alexanderbarsuk/diesel-heater/tools/background.png

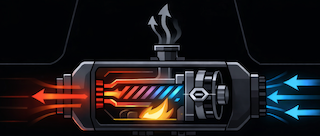
tools/background.png
