alexanderbarsuk/diesel-heater/README.md

# MegaHeater2

Мікроконтролерна система керування автономним дизельним обігрівачем.

## Апаратна платформа

| Компонент | Деталь |
|---|---|
| MCU | Arduino Mega 2560 (ATmega2560, 256 KB Flash, 8 KB RAM) |
| Дисплей | ST7789 TFT 320×240, підключення через SPI |
| Енкодер | Ротаційний енкодер з кнопкою |
| Термопари | MAX6675 × 3 (K-type, SPI) |
| Датчик впуску | DS18B20 (One-Wire) |
| Датчик середовища | AHT20 (температура + вологість, I2C) + BMP280 (тиск, I2C) |
| Датчик струму | ACS712F 20A (вимірювання струму свічки) |
| Дільник напруги | Резисторний дільник R1=30 кОм, R2=10 кОм → Vmax≈20 В |

---

## Підключення сенсорів і виходів

### SPI (SCK=52, MISO=50, MOSI=51)
| Пін CS | Сенсор |
|---|---|
| 10 | MAX6675 — камера згорання |
| 11 | MAX6675 — вихлоп |
| 12 | MAX6675 — повітря на виході (тепле) |
| 53 | ST7789 TFT — CS |
| 48 | ST7789 TFT — DC |
| 49 | ST7789 TFT — RST |

### I2C (SDA=20, SCL=21)
| Адреса | Сенсор |
|---|---|
| 0x38 | AHT20 (температура + вологість) |
| 0x76 або 0x77 | BMP280 (атмосферний тиск) |

### One-Wire
| Пін | Сенсор |
|-----|---|
| 23 | DS18B20 — повітря на вході (холодне) |

### Аналогові входи
| Пін | Призначення |
|-----|---|
| A0 | Дільник напруги живлення (≤20 В через дільник R1=30к/R2=10к) |
| A1 | ACS712F 20A — струм свічки запалювання (0A → 2.5V / ADC≈512; ~20.5 ADC/А) |

> **Важливо:** A0 при непідключеному дільнику є плаваючим входом і показує шум. Підключіть 10 кОм на GND при відсутності дільника.

### Цифрові входи
| Пін | Режим | Призначення |
|-----|---|---|
| 2 | INPUT (INT) | Енкодер CLK |
| 3 | INPUT (INT) | Енкодер DT |
| 4 | INPUT | Енкодер SW (кнопка) |
| 5 | INPUT | Кнопка перемикання екранів |
| 18 | INPUT_PULLUP (INT3) | Тахометр вентилятора (2 імп/об) |
| 19 | INPUT_PULLUP (INT2) | Тахометр насоса (1 імп/об) |
| 24 | INPUT | Аварійний контакт (HIGH = спрацювало) |
| 25 | INPUT | Датчик переливу пального (HIGH = спрацювало) |
| 26 | INPUT | Датчик мінімуму пального (HIGH = спрацювало) |
| 28 | INPUT | Кнопка режиму "Нагрів" (HIGH = натиснуто) |
| 30 | INPUT | Кнопка режиму "Вентиляція" (HIGH = натиснуто) |
| 32 | INPUT | Кнопка прокачки пального (HIGH = натиснуто) |
| 34 | INPUT | Вхід ехо-сигналу (дублюється на пін 35) |

### Цифрові виходи
| Пін | Призначення | Активний рівень |
|-----|---|---|
| 6 | ШІМ вентилятора (OC4A, Timer4) | HIGH |
| 7 | ШІМ паливного насоса (OC4B, Timer4) | HIGH |
| 8 | Паливний клапан | HIGH = відкрито |
| 9 | Свічка запалювання | HIGH = активна |
| 27 | Зарядка акумулятора | HIGH = заряджати |
| 29 | LED режиму "Нагрів" | HIGH = світить |
| 31 | LED режиму "Вентиляція" | HIGH = світить |
| 33 | Бузер | HIGH = звук |
| 35 | Вихід ехо-сигналу (дублює пін 34) | — |
| 46 | Тактовий сигнал 2 Гц (OC5A, Timer5 CTC) | меандр |

---

## Режими роботи

| Режим | Опис |
|---|---|
| **Нагрів** (MODE_HEAT) | Нормальний режим. Вентилятор + насос + свічка під час запуску |
| **Вентиляція** (MODE_VENT) | Тільки вентилятор, насос і свічка не вмикаються |

Режим обирається кнопками BTN_HEAT / BTN_VENT тільки у стані ВИМКНЕНО або ПОМИЛКА.

---

## Стани обігрівача

```
                          [ignitionTime вичерпано, 1-ша спроба]
                        ┌─────────────────────────────────────┐
                        │                                     ▼
ВИМКНЕНО ─[Toggle]─► ЗАПУСК                             ПЕРЕЗАПУСК
                        │                                     │
               [вихлоп ≥ startFireTemp]            [вихлоп ≥ startFireTemp]
                        │                                     │
                        └──────────► НОРМАЛЬНА РОБОТА ◄───────┘
                                           │   │
                                    [Toggle]   [вихлоп < startFireTemp]
                                           │               │
                                           ▼               ▼
              FAULT ◄─[ignitionTime]─ ОХОЛОДЖЕННЯ ◄── ПЕРЕЗАПУСК (одна спроба)
                                           │
                                  [камера ≤ coolStopTemp]
                                           │
                                           ▼
                                    ВИМКНЕНО / ПОМИЛКА
```

| Стан | Клапан | Свічка | Вентилятор | Насос |
|---|---|---|---|---|
| ВИМКНЕНО | — | — | — | — |
| ЗАПУСК | Відкрито | Увімкнена (до ignitionTime) | startFanRpm | startPumpRpm (після затримки) |
| ПЕРЕЗАПУСК | Відкрито | Увімкнена (до ignitionTime) | startFanRpm | startPumpRpm (після затримки) |
| НОРМАЛЬНА РОБОТА | Відкрито | — | POWER_TABLE[power] | POWER_TABLE[power] |
| ОХОЛОДЖЕННЯ | — | — | coolFanRpm | — |
| ПОМИЛКА | — | — | — | — |
| ПРОКАЧКА | Відкрито | — | — | MAX (255) |

---

## Алгоритм запуску

1. Натиснута кнопка Toggle → стан переходить у **ЗАПУСК**
2. Вмикається паливний клапан
3. Вентилятор виходить на `startFanRpm` через ПІД-регулятор
4. Свічка запалювання вмикається
5. Якщо задана `Затримка насоса` > 0 — насос стоїть задану кількість секунд
6. Після затримки насос виходить на `startPumpRpm` через ПІД
7. Через 1000 мс після ввімкнення свічки — перевірка струму ACS712:
   - Якщо струм < `Мін.струм свічки` і налаштування ≠ 0 → **FAULT_IGNITION_OPEN**
8. Якщо температура вихлопу досягає `startFireTemp` → стан **НОРМАЛЬНА РОБОТА**, свічка вимикається
9. Якщо час `ignitionTime` вичерпано і займання не відбулося:
   - Перша спроба → **ПЕРЕЗАПУСК** (повторює кроки 3–8)
   - Друга спроба не вдалася → **FAULT_NO_IGNITION** → **ОХОЛОДЖЕННЯ**

## Відновлення після перебою живлення

При увімкненні контролера виконується перевірка температури камери згорання:
- Якщо `tempChamber > coolStopTemp` → контролер одразу переходить у стан **ОХОЛОДЖЕННЯ**
- Вентилятор виходить на `coolFanRpm` і охолоджує камеру до досягнення порогу
- Після охолодження — стан **ВИМКНЕНО** (без аварії)

Це захищає від ситуацій, коли живлення зникло під час роботи обігрівача.

## Алгоритм зупинки

1. Натиснута кнопка Toggle (або спрацювала аварія) → стан **ОХОЛОДЖЕННЯ**
2. Паливний клапан і свічка вимикаються, насос зупиняється
3. Вентилятор виходить на `coolFanRpm` через ПІД
4. Коли температура камери ≤ `coolStopTemp` → стан **ВИМКНЕНО** (або **ПОМИЛКА** якщо причина аварія)

## Алгоритм прокачки

- Режим **Утримання**: насос на MAX при натиснутій кнопці PRIMING, зупиняється при відпусканні
- Режим **Таймер**: насос на MAX протягом заданого часу після натискання кнопки
- Доступна тільки у стані ВИМКНЕНО або ПОМИЛКА
- Паливний клапан відкривається під час прокачки

## ПІД-регулятори

Velocity-form PI (оновлення раз на 1 секунду):

```
Δu = Kp*(e - e_prev) + Ki*e
u[k] = clamp(u[k-1] + Δu, 0, 255)
```

| Параметр | За замовч. | Одиниці |
|---|---|---|
| Вентилятор Kp | 0.040 | ШІМ/RPM |
| Вентилятор Ki | 0.008 | ШІМ/RPM |
| Насос Kp | 0.400 | ШІМ/RPM |
| Насос Ki | 0.080 | ШІМ/RPM |

## Таблиця потужності (10 ступенів)

| Ступінь | Вентилятор (об/хв) | Насос (об/хв) |
|---|---|---|
| 1 | 1200 | 60 |
| 2 | 1550 | 78 |
| 3 | 1950 | 102 |
| 4 | 2350 | 132 |
| 5 | 2750 | 168 |
| 6 | 3150 | 210 |
| 7 | 3550 | 258 |
| 8 | 3950 | 312 |
| 9 | 4350 | 372 |
| 10 | 4800 | 420 |

## Зарядка акумулятора

Якщо напруга живлення нижче порогу `Поріг зарядки` — вихід CHARGER_PIN переходить у HIGH (ввімкнення зовнішнього зарядника). Перевіряється кожну секунду.

## Таймер автовимкнення

При ввімкненому таймері обігрівач автоматично зупиняється після заданого часу роботи. Налаштовується через меню (увімкнення + тривалість).

---

## Перелік помилок

| Код | Короткий код | Назва | Умова спрацювання |
|-----|---|---|---|
| 1 | Е:КАМ | ПЕРЕГРІВ КАМЕРИ | tempChamber > maxChamber (за замовч. 310°C) |
| 2 | Е:ВИХ | ПЕРЕГРІВ ВИХЛОПУ | tempExhaust > maxExhaust (за замовч. 380°C) |
| 3 | Е:ЗАП | НЕ ЗАПАЛЮЄТЬСЯ | Вихлоп не досяг startFireTemp за обидві спроби ignitionTime |
| 4 | Е:СКМ | ДАТЧИК КАМЕРИ | MAX6675 повертає NAN (термопара відключена) |
| 5 | Е:СВХ | ДАТЧИК ВИХЛОПУ | MAX6675 повертає NAN (термопара відключена) |
| 6 | Е:НАП | НИЗЬКА НАПРУГА | voltage < voltageMin (за замовч. 8.0 В) |
| 7 | Е:ВАП | ВИСОКА НАПРУГА | voltage > voltageMax (за замовч. 30.0 В) |
| 8 | Е:КОН | АВАРІЙНИЙ КОНТАКТ | SENSOR_EMERGENCY_PIN = HIGH |
| 9 | Е:ПЕР | ПЕРЕЛИВ ПАЛЬНОГО | SENSOR_FUEL_OVERFLOW_PIN = HIGH |
| 10 | Е:БАК | МІНІМУМ ПАЛЬНОГО | SENSOR_FUEL_MIN_PIN = HIGH |
| 11 | Е:ВПС | ПЕРЕГРІВ ВПУСКУ | tempAirIn > maxAirIn (за замовч. 20°C) |
| 12 | Е:СВЧ | ОБРИВ СВІЧКИ | Струм свічки < Мін.струм через 1 с після ввімкнення (якщо налаштування ≠ 0) |

**Поведінка при аварії:**
- Під час активної роботи → стан **ОХОЛОДЖЕННЯ** (вентилятор продовжує працювати до coolStopTemp)
- Після охолодження → стан **ПОМИЛКА**
- З ВИМКНЕНО або ЗУПИНКИ → одразу **ПОМИЛКА**

Журнал помилок зберігається в EEPROM (кільцевий буфер, до 100 записів). Переглядається на екрані аварій.

---

## Налаштування

Доступні через екран налаштувань (поворот енкодера = навігація, натискання = редагування/підтвердження).

### Головне меню

| Параметр | Тип | Діапазон | За замовч. | Опис |
|---|-----|---|---|---|
| Таймер | Checkbox | Викл/Вкл | Викл | Увімкнення таймера автовимкнення |
| Час таймера | Час | 0–23:59:59 | 0:30:00 | Тривалість роботи за таймером |
| Режим прокачки | Вибір | Утримання / Таймер | Утримання | Режим кнопки прокачки |
| Час прокачки | Час | 0–23:59:59 | 0:00:10 | Тривалість прокачки в режимі Таймер |
| Напруга живлення | Діапазон | 3–30 В | 10–25 В | Допустимий діапазон напруги |
| Поріг зарядки | Слайдер | 9–14 В | 11 В | Нижче — вмикається зарядник |

### Підменю "Запуск"

| Параметр | Тип | Діапазон | За замовч. | Опис |
|---|-----|---|---|---|
| Час роботи свічки | Час | 0–23:59:59 | 0:01:00 | Максимальний час роботи свічки за одну спробу |
| Оберти вентилятора | Слайдер | 500–3000 RPM | 1200 RPM | Оберти вентилятора під час запуску |
| Оберти насоса | Слайдер | 30–500 RPM | 60 RPM | Оберти насоса під час запуску |
| Температура займання | Слайдер | 100–500°C | 300°C | Температура вихлопу, що підтверджує займання |
| Затримка насоса | Слайдер | 0–120 с | 0 с | Час після старту, протягом якого насос не вмикається |

### Підменю "Зупинка"

| Параметр | Тип | Діапазон | За замовч. | Опис |
|---|-----|---|---|---|
| Оберти вентилятора | Слайдер | 500–3000 RPM | 1500 RPM | Оберти вентилятора під час охолодження |
| Цільова температура | Слайдер | 30–150°C | 80°C | Температура камери для завершення охолодження |

### Підменю "Аварії"

| Параметр | Тип | Діапазон | За замовч. | Опис |
|---|-----|---|---|---|
| Макс темп впуску | Слайдер | 5–30°C | 20°C | Максимально допустима температура холодного повітря на вході |
| Перегрів корпусу | Слайдер | 300–500°C | 310°C | Поріг аварії камери згорання |
| Перегрів вихлопу | Слайдер | 300–600°C | 380°C | Поріг аварії вихлопної труби |
| Мін.струм свічки | Слайдер | 0–20 А | 2 А | Мінімальний струм для підтвердження роботи свічки (0 = перевірку вимкнено) |
| Час бузера | Слайдер | 0–30 с | 3 с | Тривалість звукового сигналу при аварії (0 = вимкнено) |

### Підменю "ПІД регулятор"

| Параметр | Тип | Діапазон | За замовч. | Опис |
|---|-----|---|---|---|
| Вентилятор Kp | Слайдер | 0–0.999 | 0.040 | Пропорційний коефіцієнт вентилятора |
| Вентилятор Ki | Слайдер | 0–0.999 | 0.008 | Інтегральний коефіцієнт вентилятора |
| Насос Kp | Слайдер | 0–0.999 | 0.400 | Пропорційний коефіцієнт насоса |
| Насос Ki | Слайдер | 0–0.999 | 0.080 | Інтегральний коефіцієнт насоса |

### Підменю "Потужність"

10 ступенів (1–10). Кожен задає цільові оберти насоса та вентилятора у вигляді діапазону (lo=насос, hi=вентилятор, 0–5000 RPM).

---

## EEPROM

| Адреса | Розмір | Призначення |
|---|---|---|
| 6 | 4 B | Час прокачки (секунди) |
| 14 | 4 B | Час прокачки (TIME) |
| 18 | 4 B | Час роботи свічки (TIME) |
| 24 | 2 B | Поріг зарядки |
| 26 | 2 B | Режим прокачки |
| 28 | 2 B | Оберти вентилятора запуску |
| 32 | 2 B | Макс темп впуску |
| 34 | 2 B | Перегрів корпусу |
| 36 | 2 B | Перегрів вихлопу |
| 38–44 | 2 B × 4 | ПІД коефіцієнти (×1000) |
| 46–85 | 4 B × 10 | Таблиця потужності (10 ступенів) |
| 86 | 2 B | Оберти насоса запуску |
| 88 | 2 B | Температура займання |
| 90 | 2 B | Оберти вентилятора охолодження |
| 92 | 2 B | Температура зупинки охолодження |
| 94 | 2 B | Таймер увімкнений |
| 96 | 4 B | Тривалість таймера (секунди) |
| 100 | 1 B | Magic byte налаштувань (0xB0) |
| 102 | 2 B | Затримка насоса при запуску |
| 104 | 2 B | Мінімальний струм свічки |
| 106 | 2 B | Час бузера при аварії |
| 200–399 | 200 B | Журнал аварій (кільцевий буфер 100 × 2 байти: code + arg) |
| 400 | 1 B | Кількість записів журналу |
| 401 | 1 B | Head (індекс найстарішого запису) |
| 402 | 1 B | Seed magic журналу (0xB2) |

При невідповідності magic byte (адреса 100) усі налаштування скидаються до значень за замовчуванням і записуються в EEPROM.

---

## Збірка та прошивка

```bash
# Компіляція
arduino-cli compile --fqbn arduino:avr:mega:cpu=atmega2560 .

# Прошивка
arduino-cli upload -p /dev/cu.usbserial-110 --fqbn arduino:avr:mega:cpu=atmega2560 .
```

Поточний розмір: ~163 KB Flash (64%), ~4.7 KB RAM (57%).
