alexanderbarsuk/diesel-heater/screen_settings.cpp

#include "screen_settings.h"
#include "uaprint.h"
#include "encoder.h"
#include "config.h"
#include "heater.h"
#include "timer.h"
#include <EEPROM.h>

// ─── Типи елементів меню ─────────────────────────────────────────────────────
enum MenuItemType : uint8_t {
  ITEM_SLIDER,    // int16_t в [minVal..maxVal], відображається з одиницями
  ITEM_CHECKBOX,  // int16_t 0/1 → "ВИКЛ"/"ВКЛ"
  ITEM_TIME,      // uint32_t секунди (0..86399), 3 поля редагування: Г/Х/С
  ITEM_RANGE,     // два int16_t packed lo|hi<<16, обидва в [minVal..maxVal], lo≤hi
  ITEM_SELECT,    // int16_t індекс 0..maxVal в масиві data[]
  ITEM_SUBMENU,   // перехід у підменю; data → SubMenuDef; valIdx=NO_VAL
  ITEM_BACK,      // повернення до батьківського меню; valIdx=NO_VAL
};

#define NO_VAL 0xFF  // valIdx для ITEM_SUBMENU та ITEM_BACK

// ─── Структура підменю ───────────────────────────────────────────────────────
struct MenuItem;  // forward declaration

struct SubMenuDef {
  const char*     title;   // заголовок підменю (UTF-8, до 12 символів)
  const MenuItem* items;   // масив елементів
  uint8_t         count;   // кількість елементів
};

// ─── Структура елемента меню ─────────────────────────────────────────────────
struct MenuItem {
  const char*   label;      // UTF-8, рівно 10 видимих символів
  MenuItemType  type;
  uint8_t       valIdx;     // індекс у values[]; NO_VAL для SUBMENU/BACK
  uint8_t       eepromAddr; // EEPROM-адреса (2B для SLIDER/CHECKBOX/SELECT, 4B для TIME/RANGE)
  int16_t       minVal;     // SLIDER/RANGE: нижня межа; SELECT: 0; SUBMENU/BACK: 0
  int16_t       maxVal;     // SLIDER/RANGE: верхня межа; SELECT: кількість опцій-1
  int32_t       defaultVal; // значення за замовчуванням
  const char*   units;      // UTF-8 рядок одиниць або NULL
  const void*   data;       // SELECT: const char**; SUBMENU: const SubMenuDef*; інакше NULL
};

// ─── Рядки одиниць ───────────────────────────────────────────────────────────
static const char UNITS_C[]   = "\xC2\xB0""C";              // °C  (2 CP)
static const char UNITS_PCT[] = "%";
static const char UNITS_HPA[] = "\xD0\xB3\xD0\x9F\xD0\xB0"; // гПа (3 CP)
static const char UNITS_V[]   = "В";
static const char UNITS_RPM[] = "RPM";
static const char UNITS_S[]   = "с";
static const char UNITS_A[]   = "А";

// ─── Опції для ITEM_SELECT ───────────────────────────────────────────────────
static const char* modeOpts[]        = { "Авто ", "Нагрів", "Вентиляція" };
static const char* primingModeOpts[] = { "Утримання", "Таймер" };

// ─── Підменю "ПОТУЖНІСТЬ" (таблиця 10 ступенів) ──────────────────────────────
// lo = pumpRpm (оберти насоса), hi = fanRpm (оберти вент.) — lo≤hi завжди ✓
// valIdx 20..29  EEPROM addr 46..85  (4B кожен = ITEM_RANGE: lo(2B)+hi(2B))
#define MK_STEP(pump, fan) \
  (int32_t)((uint16_t)(pump) | ((uint32_t)(uint16_t)(fan) << 16))
static const MenuItem powerItems[] = {
  // label           type        valIdx  addr   min   max   default              units    data
  { "< Назад   ", ITEM_BACK,    NO_VAL,  0,      0,    0,   0,                  nullptr, nullptr },
  { "Ступінь 1 ", ITEM_RANGE,   20,     46,      0, 5000,   MK_STEP( 60, 1200), nullptr, nullptr },
  { "Ступінь 2 ", ITEM_RANGE,   21,     50,      0, 5000,   MK_STEP( 78, 1550), nullptr, nullptr },
  { "Ступінь 3 ", ITEM_RANGE,   22,     54,      0, 5000,   MK_STEP(102, 1950), nullptr, nullptr },
  { "Ступінь 4 ", ITEM_RANGE,   23,     58,      0, 5000,   MK_STEP(132, 2350), nullptr, nullptr },
  { "Ступінь 5 ", ITEM_RANGE,   24,     62,      0, 5000,   MK_STEP(168, 2750), nullptr, nullptr },
  { "Ступінь 6 ", ITEM_RANGE,   25,     66,      0, 5000,   MK_STEP(210, 3150), nullptr, nullptr },
  { "Ступінь 7 ", ITEM_RANGE,   26,     70,      0, 5000,   MK_STEP(258, 3550), nullptr, nullptr },
  { "Ступінь 8 ", ITEM_RANGE,   27,     74,      0, 5000,   MK_STEP(312, 3950), nullptr, nullptr },
  { "Ступінь 9 ", ITEM_RANGE,   28,     78,      0, 5000,   MK_STEP(372, 4350), nullptr, nullptr },
  { "Ступінь 10", ITEM_RANGE,   29,     82,      0, 5000,   MK_STEP(420, 4800), nullptr, nullptr },
};
static const SubMenuDef corrSubDef = { "ПОТУЖНІСТЬ", powerItems, 11 };

// ─── Підменю "АВАРІЇ" ────────────────────────────────────────────────────────
// Temp thresholds: valIdx 13..15, addr 32..36 (2B кожен)
// Ignition current: valIdx 40, addr 104 (2B)
// Buzzer duration: valIdx 41, addr 106 (2B)
static const MenuItem dangerItems[] = {
  // label                       type        valIdx  addr  min   max  default  units    data
  { "< Назад   ",             ITEM_BACK,    NO_VAL,   0,    0,    0,   0,      nullptr, nullptr },
  { "Макс темп впуску",       ITEM_SLIDER,  13,      32,    5,   30,  20,      UNITS_C, nullptr },
  { "Перегрів корпусу",       ITEM_SLIDER,  14,      34,  300,  500, 310,      UNITS_C, nullptr },
  { "Перегрів вихлопу",       ITEM_SLIDER,  15,      36,  300,  600, 380,      UNITS_C, nullptr },
  { "Мін.струм свічки",       ITEM_SLIDER,  40,     104,    0,   20,   2,      UNITS_A, nullptr },
  { "Час бузера  ",           ITEM_SLIDER,  41,     106,    0,   30,   3,      UNITS_S, nullptr },
};
static const SubMenuDef dangerSubDef = { "АВАРІЇ", dangerItems, 6 };

// ─── Підменю "ЗАПУСК" ────────────────────────────────────────────────────────
// valIdx 32..34, 39  EEPROM addr 28, 86, 88, 102  (2B кожен)
static const MenuItem startItems[] = {
  // label                      type        valIdx  addr   min   max   default  units    data
  { "< Назад   ",             ITEM_BACK,    NO_VAL,   0,     0,    0,    0,      nullptr,   nullptr },
  { "Час роботи свічки",      ITEM_TIME,     7,      18,     0,    0,   60,      nullptr,   nullptr },
  { "Оберти вентилятора",     ITEM_SLIDER,  32,      28,   500, 3000, 1200,      UNITS_RPM, nullptr },
  { "Оберти насоса",          ITEM_SLIDER,  33,      86,    30,  500,   60,      UNITS_RPM, nullptr },
  { "Температура займання",   ITEM_SLIDER,  34,      88,   100,  500,  300,      UNITS_C,   nullptr },
  { "Затримка насоса",        ITEM_SLIDER,  39,     102,     0,  120,    0,      UNITS_S,   nullptr },
};
static const SubMenuDef startSubDef = { "ЗАПУСК", startItems, 6 };

// ─── Підменю "ЗУПИНКА" ───────────────────────────────────────────────────────
// valIdx 35..36  EEPROM addr 90, 92  (2B кожен)
static const MenuItem stopItems[] = {
  // label                    type        valIdx  addr   min   max   default  units    data
  { "< Назад   ",           ITEM_BACK,    NO_VAL,   0,     0,    0,    0,      nullptr, nullptr },
  { "Оберти вентилятора",   ITEM_SLIDER,  35,      90,   500, 3000, 1500,      UNITS_RPM, nullptr },
  { "Цільова температура",  ITEM_SLIDER,  36,      92,    30,  150,   80,      UNITS_C, nullptr },
};
static const SubMenuDef stopSubDef = { "ЗУПИНКА", stopItems, 3 };

// ─── Підменю "ПІД" ───────────────────────────────────────────────────────────
// valIdx 16..19  EEPROM addr 38..44  (2B кожен)
// Значення зберігаються як ×1000 цілі: 40 = Kp 0.040 [ШІМ/RPM]
static const MenuItem pidItems[] = {
  // label              type        valIdx  addr  min   max  default  units     data
  { "< Назад   ",     ITEM_BACK,    NO_VAL,   0,    0,    0,    0,    nullptr,  nullptr },
  { "Вентилятор Kp",  ITEM_SLIDER,  16,      38,    0,  999,   40,    nullptr,  nullptr },
  { "Вентилятор Ki",  ITEM_SLIDER,  17,      40,    0,  999,    8,    nullptr,  nullptr },
  { "Насос Kp",       ITEM_SLIDER,  18,      42,    0,  999,  400,    nullptr,  nullptr },
  { "Насос Ki",       ITEM_SLIDER,  19,      44,    0,  999,   80,    nullptr,  nullptr },
};
static const SubMenuDef pidSubDef = { "ПІД", pidItems, 5 };

// ─── Головне меню ────────────────────────────────────────────────────────────
// Таймер: valIdx 37 (enable, addr 94, 2B), valIdx 38 (duration, addr 96, 4B)
static const MenuItem rootItems[] = {
  // label                      type         valIdx addr  min   max   default                                        units      data
  { "Таймер    ",           ITEM_CHECKBOX, 37,  94,    0,    1,    0,                                               nullptr,   nullptr               },
  { "Час таймера",          ITEM_TIME,     38,  96,    0,    0, 1800,                                               nullptr,   nullptr               },
  { "Режим прокачки",       ITEM_SELECT,   31,  26,    0,    1,    0,                                               nullptr,   (const void*)primingModeOpts},
  { "Час прокачки",         ITEM_TIME,      6,  14,    0,    0,   10,                                               nullptr,   nullptr               },
  { "Напруга живлення",     ITEM_RANGE,     3,   6,    3,   30,  (int32_t)((uint16_t)10|((uint32_t)(uint16_t)25<<16)), UNITS_V, nullptr               },
  { "Поріг зарядки",        ITEM_SLIDER,   30,  24,    9,   14,   11,                                               UNITS_V,   nullptr               },
  { "Потужність ",          ITEM_SUBMENU, NO_VAL, 0,   0,    0,    0,                                               nullptr,   &corrSubDef           },
  { "Аварії",               ITEM_SUBMENU, NO_VAL, 0,   0,    0,    0,                                               nullptr,   &dangerSubDef         },
  { "ПІД регулятор",        ITEM_SUBMENU, NO_VAL, 0,   0,    0,    0,                                               nullptr,   &pidSubDef            },
  { "Запуск     ",          ITEM_SUBMENU, NO_VAL, 0,   0,    0,    0,                                               nullptr,   &startSubDef          },
  { "Зупинка    ",          ITEM_SUBMENU, NO_VAL, 0,   0,    0,    0,                                               nullptr,   &stopSubDef           },
};
#define ROOT_COUNT  11

// ─── Реєстр підменю (для saveAll/loadAll) ────────────────────────────────────
static const SubMenuDef* allSubMenus[] = { &corrSubDef, &dangerSubDef, &pidSubDef, &startSubDef, &stopSubDef };
#define NUM_SUBMENUS  5

#define TOTAL_VALUES   42   // valIdx 0..41
#define ITEMS_PER_PAGE  7

#define EEPROM_MAGIC_ADDR  100
#define EEPROM_MAGIC_VAL   0xB0

// ─── Розмітка рядків (UA_ADVANCE=12, UA_ASCENT=18) ───────────────────────────
// Row = 4px top + 22px content (ascent+descent+1) + 4px bottom = 30px total
#define ROW_Y_START  27
#define ROW_HEIGHT   30

// ─── Поточний стан навігації ─────────────────────────────────────────────────
struct MenuLevel {
  const MenuItem* items;
  uint8_t         count;
  uint8_t         savedSelected;
  uint8_t         savedPage;
  const char*     savedTitle;
};
static MenuLevel       navStack[2];            // підтримка 1 рівня підменю
static uint8_t         navDepth      = 0;
static const MenuItem* currentItems  = rootItems;
static uint8_t         currentCount  = ROOT_COUNT;
static const char*     currentTitle  = "НАЛАШТУВАННЯ";

static int32_t values[TOTAL_VALUES]; // runtime-значення; valIdx є індексом
static uint8_t selectedItem = 0;
static uint8_t currentPage  = 0;
static bool    editMode     = false;
static uint8_t editField    = 0;     // TIME: 0=Г 1=Х 2=С; RANGE: 0=lo 1=hi
static int     lastEncoderPos;
static bool    lastSW;

// ─── Прокрутка довгих міток ──────────────────────────────────────────────────
static uint8_t  labelScrollOff = 0;   // поточний зсув (в символах CP)
static uint32_t labelScrollMs  = 0;   // мітка часу останнього кроку
static uint8_t  labelScrollPh  = 0;   // 0=очікування початку, 1=прокрутка, 2=пауза в кінці

static void resetLabelScroll() {
  labelScrollOff = 0;
  labelScrollPh  = 0;
  labelScrollMs  = millis();
}

// ─── EEPROM-помічники ─────────────────────────────────────────────────────────
static uint8_t fieldsForType(MenuItemType t) {
  switch (t) {
    case ITEM_TIME:  return 3;
    case ITEM_RANGE: return 2;
    default:         return 1;
  }
}

static void saveValue(const MenuItem* item) {
  if (item->valIdx == NO_VAL) return;
  switch (item->type) {
    case ITEM_SLIDER:
    case ITEM_CHECKBOX:
    case ITEM_SELECT: {
      int16_t v = (int16_t)values[item->valIdx];
      EEPROM.put(item->eepromAddr, v);
      break;
    }
    case ITEM_TIME: {
      uint32_t t = (uint32_t)values[item->valIdx];
      EEPROM.put(item->eepromAddr, t);
      break;
    }
    case ITEM_RANGE: {
      int16_t lo = (int16_t)(values[item->valIdx] & 0xFFFF);
      int16_t hi = (int16_t)((uint32_t)values[item->valIdx] >> 16);
      EEPROM.put(item->eepromAddr,     lo);
      EEPROM.put(item->eepromAddr + 2, hi);
      break;
    }
    default: break;
  }
}

static void loadValue(const MenuItem* item) {
  if (item->valIdx == NO_VAL) return;
  switch (item->type) {
    case ITEM_SLIDER:
    case ITEM_CHECKBOX:
    case ITEM_SELECT: {
      int16_t v;
      EEPROM.get(item->eepromAddr, v);
      values[item->valIdx] = constrain(v, item->minVal, item->maxVal);
      break;
    }
    case ITEM_TIME: {
      uint32_t t;
      EEPROM.get(item->eepromAddr, t);
      if (t > 86399) t = 0;
      values[item->valIdx] = (int32_t)t;
      break;
    }
    case ITEM_RANGE: {
      int16_t lo, hi;
      EEPROM.get(item->eepromAddr,     lo);
      EEPROM.get(item->eepromAddr + 2, hi);
      lo = constrain(lo, item->minVal, item->maxVal);
      hi = constrain(hi, lo, item->maxVal);
      values[item->valIdx] = (int32_t)((uint16_t)lo | ((uint32_t)(uint16_t)hi << 16));
      break;
    }
    default: break;
  }
}

static void initDefaults() {
  for (uint8_t i = 0; i < ROOT_COUNT; i++)
    if (rootItems[i].valIdx != NO_VAL)
      values[rootItems[i].valIdx] = rootItems[i].defaultVal;
  for (uint8_t s = 0; s < NUM_SUBMENUS; s++)
    for (uint8_t i = 0; i < allSubMenus[s]->count; i++)
      if (allSubMenus[s]->items[i].valIdx != NO_VAL)
        values[allSubMenus[s]->items[i].valIdx] = allSubMenus[s]->items[i].defaultVal;
}

static void saveAll() {
  for (uint8_t i = 0; i < ROOT_COUNT; i++)
    saveValue(&rootItems[i]);
  for (uint8_t s = 0; s < NUM_SUBMENUS; s++)
    for (uint8_t i = 0; i < allSubMenus[s]->count; i++)
      saveValue(&allSubMenus[s]->items[i]);
}

static void loadAll() {
  initDefaults();
  if (EEPROM.read(EEPROM_MAGIC_ADDR) != EEPROM_MAGIC_VAL) {
    saveAll();
    EEPROM.write(EEPROM_MAGIC_ADDR, EEPROM_MAGIC_VAL);
    return;
  }
  for (uint8_t i = 0; i < ROOT_COUNT; i++)
    loadValue(&rootItems[i]);
  for (uint8_t s = 0; s < NUM_SUBMENUS; s++)
    for (uint8_t i = 0; i < allSubMenus[s]->count; i++)
      loadValue(&allSubMenus[s]->items[i]);
}

// Передаємо поріг зарядки в heater.cpp
static void applyCharger() {
  heaterSetChargerThreshold((float)values[30]);
}

// Передаємо пороги аварій та діапазон напруги в heater.cpp
static void applyDanger() {
  heaterSetFaultThresholds(
    (int16_t)values[15],   // Перегрів вихлопу
    (int16_t)values[14],   // Перегрів корпусу
    (int16_t)values[13]    // Макс темп впуску
  );
  int16_t vMin = (int16_t)(values[3] & 0xFFFF);
  int16_t vMax = (int16_t)((uint32_t)values[3] >> 16);
  heaterSetVoltageRange((float)vMin, (float)vMax);
  heaterSetIgnitionCurrentMin((uint8_t)values[40]);
  heaterSetBuzzerDuration((uint32_t)values[41]);
}

// Передаємо параметри запуску/зупинки в heater.cpp
static void applyStartup() {
  heaterSetIgnitionTime((uint32_t)values[7]);
  heaterSetStartFanRpm((uint16_t)values[32]);
  heaterSetStartPumpRpm((uint16_t)values[33]);
  heaterSetStartFireTemp((uint16_t)values[34]);
  heaterSetCoolFanRpm((uint16_t)values[35]);
  heaterSetCoolStopTemp((uint16_t)values[36]);
  heaterSetStartPumpDelay((uint32_t)values[39]);
}

// Передаємо налаштування прокачки в heater.cpp
static void applyPriming() {
  heaterSetPrimingMode((uint8_t)values[31]);
  heaterSetPrimingDuration((uint32_t)values[6]);
}

// Передаємо ПІД-коефіцієнти в heater.cpp (values ×1000 → float)
static void applyPid() {
  heaterSetPid(values[16] * 0.001f, values[17] * 0.001f,
               values[18] * 0.001f, values[19] * 0.001f);
}

// Передаємо налаштування таймера в timer.cpp
static void applyTimer() {
  timerSetEnabled(values[37] != 0);
  timerSetDuration((uint32_t)values[38]);
}

// Передаємо таблицю потужності в heater.cpp (lo=pumpRpm, hi=fanRpm)
static void applyPowerTable() {
  for (uint8_t i = 0; i < 10; i++) {
    uint16_t pumpRpm = (uint16_t)(values[20 + i] & 0xFFFF);
    uint16_t fanRpm  = (uint16_t)((uint32_t)values[20 + i] >> 16);
    heaterSetPowerStep(i, fanRpm, pumpRpm);
  }
}

// ─── Відображення ─────────────────────────────────────────────────────────────
static void drawPageIndicator() {
  uint8_t totalPages = (currentCount + ITEMS_PER_PAGE - 1) / ITEMS_PER_PAGE;
  tft.fillRect(148, 0, 172, 26, ST77XX_BLACK);
  int cx = 314 - (totalPages - 1) * 16;
  for (uint8_t p = 0; p < totalPages; p++, cx += 16) {
    if (p == currentPage)
      tft.fillCircle(cx, 13, 4, ST77XX_CYAN);
    else
      tft.drawCircle(cx, 13, 4, tft.color565(80, 80, 80));
  }
}

static uint8_t countCP(const char* s) {
  uint8_t n = 0;
  while (*s) {
    if (((uint8_t)*s & 0xC0) != 0x80) n++;
    s++;
  }
  return n;
}

static void printSpaces(uint8_t n, uint16_t clr, uint16_t bg) {
  char sp[13];
  if (n > 12) n = 12;
  memset(sp, ' ', n);
  sp[n] = '\0';
  printUA(sp, clr, bg);
}

// Відображає поле значення (12 CP) з поточної позиції курсора
static void drawValueArea(const MenuItem* item, uint16_t rowBg) {
  bool     isEdit  = editMode && (&currentItems[selectedItem] == item);
  uint16_t normClr = ST77XX_WHITE;
  uint16_t editClr = ST77XX_YELLOW;
  uint16_t valClr  = isEdit ? editClr : normClr;

  switch (item->type) {

    case ITEM_SUBMENU:
      // "          >" = 10 пробілів + ">" = 11 CP
      printUA("          >", normClr, rowBg);
      break;

    case ITEM_BACK:
      printSpaces(11, normClr, rowBg);
      break;

    case ITEM_SLIDER: {
      char numStr[8];
      snprintf(numStr, sizeof(numStr), "%d", (int)(int16_t)values[item->valIdx]);
      uint8_t numCP  = (uint8_t)strlen(numStr);
      uint8_t unitCP = item->units ? countCP(item->units) : 0;
      uint8_t total  = numCP + (unitCP > 0 ? 1 + unitCP : 0);
      uint8_t pad    = (total < 11) ? 11 - total : 0;
      printSpaces(pad, normClr, rowBg);
      printUA(numStr, valClr, rowBg);
      if (unitCP > 0) {
        printUA(" ", normClr, rowBg);
        printUA(item->units, normClr, rowBg);
      }
      break;
    }

    case ITEM_CHECKBOX:
      // 8 пробілів + "ВКЛ"(3CP) або 7 пробілів + "ВИКЛ"(4CP) = 11 CP
      printUA(values[item->valIdx]
                ? "        \xD0\x92\xD0\x9A\xD0\x9B"
                : "       \xD0\x92\xD0\x98\xD0\x9A\xD0\x9B",
              valClr, rowBg);
      break;

    case ITEM_SELECT: {
      const char** opts = (const char**)item->data;
      const char*  opt  = opts[(int)values[item->valIdx]];
      uint8_t optCP = countCP(opt);
      uint8_t pad   = (optCP < 11) ? 11 - optCP : 0;
      printSpaces(pad, normClr, rowBg);
      printUA(opt, valClr, rowBg);
      break;
    }

    case ITEM_TIME: {
      uint32_t t = (uint32_t)values[item->valIdx];
      uint8_t  h = t / 3600, m = (t % 3600) / 60, s = t % 60;
      char hStr[3], mStr[3], sStr[3];
      snprintf(hStr, 3, "%02d", h);
      snprintf(mStr, 3, "%02d", m);
      snprintf(sStr, 3, "%02d", s);
      // "  HH:MM:SS " = 2+2+1+2+1+2+1 = 11 CP
      printUA("  ", normClr, rowBg);
      printUA(hStr, (isEdit && editField == 0) ? editClr : normClr, rowBg);
      printUA(":", normClr, rowBg);
      printUA(mStr, (isEdit && editField == 1) ? editClr : normClr, rowBg);
      printUA(":", normClr, rowBg);
      printUA(sStr, (isEdit && editField == 2) ? editClr : normClr, rowBg);
      printUA(" ", normClr, rowBg);
      break;
    }

    case ITEM_RANGE: {
      int16_t lo = (int16_t)(values[item->valIdx] & 0xFFFF);
      int16_t hi = (int16_t)((uint32_t)values[item->valIdx] >> 16);
      char loStr[5], hiStr[5];
      snprintf(loStr, 5, "%d", (int)lo);
      snprintf(hiStr, 5, "%d", (int)hi);
      uint8_t loCP   = (uint8_t)strlen(loStr);
      uint8_t hiCP   = (uint8_t)strlen(hiStr);
      uint8_t unitCP = item->units ? countCP(item->units) : 0;
      uint8_t content = loCP + 2 + hiCP + (unitCP > 0 ? 1 + unitCP : 0);
      uint8_t pad     = (content < 11) ? 11 - content : 0;
      printSpaces(pad, normClr, rowBg);
      printUA(loStr, (isEdit && editField == 0) ? editClr : normClr, rowBg);
      printUA("..", normClr, rowBg);
      printUA(hiStr, (isEdit && editField == 1) ? editClr : normClr, rowBg);
      if (unitCP > 0) {
        printUA(" ", normClr, rowBg);
        printUA(item->units, normClr, rowBg);
      }
      break;
    }
  }
}

static void drawRow(uint8_t row) {
  uint8_t idx = currentPage * ITEMS_PER_PAGE + row;
  int     y   = ROW_Y_START + row * ROW_HEIGHT;

  if (idx >= currentCount) {
    tft.fillRect(0, y, 320, ROW_HEIGHT - 2, ST77XX_BLACK);
    return;
  }

  const MenuItem* item  = &currentItems[idx];
  bool            sel   = (idx == selectedItem);
  uint16_t        rowBg = sel ? tft.color565(0, 0, 80) : ST77XX_BLACK;

  // ITEM_SUBMENU і ITEM_BACK: ціанова мітка для навігаційних пунктів
  uint16_t labelClr = (item->type == ITEM_SUBMENU || item->type == ITEM_BACK)
                        ? ST77XX_CYAN : ST77XX_WHITE;

  tft.fillRect(  0, y,      320,  4, rowBg);
  tft.fillRect(  0, y + 26, 320,  4, rowBg);
  tft.fillRect(  0, y +  4,   4, 22, rowBg);
  tft.fillRect(316, y +  4,   4, 22, rowBg);

  tft.setCursor(4, y + 22);
  uint8_t soff = (sel && !editMode) ? labelScrollOff : 0;
  printUAn(item->label, soff, 15, labelClr, rowBg);
  drawValueArea(item, rowBg);
}

static void drawFullMenu() {
  tft.fillScreen(ST77XX_BLACK);
  tft.setCursor(4, 22);
  printUA(currentTitle, ST77XX_CYAN, ST77XX_BLACK);
  tft.drawFastHLine(0, 26, 320, ST77XX_CYAN);
  drawPageIndicator();
  for (uint8_t r = 0; r < ITEMS_PER_PAGE; r++) drawRow(r);
}

// ─── Навігація по рівнях ──────────────────────────────────────────────────────
static void enterSubMenu() {
  if (navDepth >= 2) return;
  const SubMenuDef* sub = (const SubMenuDef*)currentItems[selectedItem].data;
  navStack[navDepth] = { currentItems, currentCount, selectedItem, currentPage, currentTitle };
  navDepth++;
  currentItems = sub->items;
  currentCount = sub->count;
  currentTitle = sub->title;
  // Починаємо з першого не-BACK пункту (якщо 0-й є BACK, то з 1-го)
  selectedItem = (currentCount > 0 && currentItems[0].type == ITEM_BACK) ? 1 : 0;
  if (selectedItem >= currentCount) selectedItem = 0;
  currentPage  = selectedItem / ITEMS_PER_PAGE;
  editMode     = false;
  editField    = 0;
  resetLabelScroll();
  drawFullMenu();
}

static void exitSubMenu() {
  if (navDepth == 0) return;
  navDepth--;
  currentItems = navStack[navDepth].items;
  currentCount = navStack[navDepth].count;
  selectedItem = navStack[navDepth].savedSelected;
  currentPage  = navStack[navDepth].savedPage;
  currentTitle = navStack[navDepth].savedTitle;
  editMode     = false;
  editField    = 0;
  resetLabelScroll();
  drawFullMenu();
}

// ─────────────────────────────────────────────────────────────────────────────
void settingsInit() {
  loadAll();
  applyStartup();
  applyPriming();
  applyPid();
  applyPowerTable();
  applyCharger();
  applyDanger();
  applyTimer();
  navDepth     = 0;
  currentItems = rootItems;
  currentCount = ROOT_COUNT;
  currentTitle = "НАЛАШТУВАННЯ";
  editMode     = false;
  editField    = 0;
  selectedItem = 0;
  currentPage  = 0;
  lastEncoderPos = encoderGetPos();
  lastSW         = digitalRead(ENCODER_SW);
  resetLabelScroll();
  drawFullMenu();
}

void settingsUpdate() {
  // ── Енкодер ──────────────────────────────────────────────────────────────
  int pos   = encoderGetPos();
  int delta = pos - lastEncoderPos;

  if (delta != 0) {
    lastEncoderPos = pos;

    if (!editMode) {
      int newSel = constrain((int)selectedItem + (delta > 0 ? 1 : -1),
                             0, (int)currentCount - 1);
      uint8_t oldPage = currentPage;
      uint8_t oldRow  = selectedItem % ITEMS_PER_PAGE;

      selectedItem = (uint8_t)newSel;
      currentPage  = selectedItem / ITEMS_PER_PAGE;
      resetLabelScroll();

      if (currentPage != oldPage) {
        drawFullMenu();
      } else {
        drawRow(oldRow);
        drawRow(selectedItem % ITEMS_PER_PAGE);
      }
    } else {
      const MenuItem* item = &currentItems[selectedItem];
      switch (item->type) {

        case ITEM_SLIDER: {
          int32_t newV = values[item->valIdx] + delta;
          values[item->valIdx] = constrain(newV,
                                           (int32_t)item->minVal,
                                           (int32_t)item->maxVal);
          break;
        }

        case ITEM_CHECKBOX:
          values[item->valIdx] ^= 1;
          break;

        case ITEM_SELECT: {
          int32_t count = (int32_t)item->maxVal + 1;
          values[item->valIdx] = ((values[item->valIdx] + delta) % count + count) % count;
          break;
        }

        case ITEM_TIME: {
          uint32_t t = (uint32_t)values[item->valIdx];
          uint8_t h = t / 3600, m = (t % 3600) / 60, s = t % 60;
          if (editField == 0) h = (uint8_t)constrain((int)h + delta, 0, 23);
          if (editField == 1) m = (uint8_t)constrain((int)m + delta, 0, 59);
          if (editField == 2) s = (uint8_t)constrain((int)s + delta, 0, 59);
          values[item->valIdx] = (int32_t)((uint32_t)h * 3600u + m * 60u + s);
          break;
        }

        case ITEM_RANGE: {
          int16_t lo = (int16_t)(values[item->valIdx] & 0xFFFF);
          int16_t hi = (int16_t)((uint32_t)values[item->valIdx] >> 16);
          if (editField == 0)
            lo = (int16_t)constrain((int)lo + delta, (int)item->minVal, (int)hi);
          else
            hi = (int16_t)constrain((int)hi + delta, (int)lo, (int)item->maxVal);
          values[item->valIdx] = (int32_t)((uint16_t)lo | ((uint32_t)(uint16_t)hi << 16));
          break;
        }

        default: break;
      }
      drawRow(selectedItem % ITEMS_PER_PAGE);
    }
  }

  // ── Кнопка енкодера ──────────────────────────────────────────────────────
  bool sw = digitalRead(ENCODER_SW);
  if (sw != lastSW) {
    lastSW = sw;
    if (sw == LOW) {
      const MenuItem* item = &currentItems[selectedItem];

      if (!editMode) {
        if (item->type == ITEM_SUBMENU) {
          enterSubMenu();   // drawFullMenu() всередині
          return;
        }
        if (item->type == ITEM_BACK) {
          exitSubMenu();    // drawFullMenu() всередині
          return;
        }
        // Звичайний елемент → входимо в режим редагування
        editMode  = true;
        editField = 0;
        drawRow(selectedItem % ITEMS_PER_PAGE);
      } else {
        uint8_t maxF = fieldsForType(item->type);
        if (editField < maxF - 1) {
          editField++;
        } else {
          saveValue(item);
          if (item->valIdx == 7 || (item->valIdx >= 32 && item->valIdx <= 36)) applyStartup();
          if (item->valIdx == 6 || item->valIdx == 31) applyPriming();
          if (item->valIdx >= 16 && item->valIdx <= 19) applyPid();
          if (item->valIdx >= 20 && item->valIdx <= 29) applyPowerTable();
          if (item->valIdx == 30) applyCharger();
          if (item->valIdx == 3 || (item->valIdx >= 13 && item->valIdx <= 15)) applyDanger();
          if (item->valIdx == 37 || item->valIdx == 38) applyTimer();
          editMode  = false;
          editField = 0;
        }
        drawRow(selectedItem % ITEMS_PER_PAGE);
      }
    }
  }

  // ── Анімація прокрутки мітки ─────────────────────────────────────────────
  if (!editMode) {
    uint8_t totalCP = countCP(currentItems[selectedItem].label);
    if (totalCP > 15) {
      uint32_t now = millis();
      if (labelScrollPh == 0) {
        if (now - labelScrollMs >= 500) {
          labelScrollPh = 1;
          labelScrollMs = now;
        }
      } else if (labelScrollPh == 1) {
        if (now - labelScrollMs >= 200) {
          labelScrollMs = now;
          labelScrollOff++;
          if (labelScrollOff + 15 >= totalCP) labelScrollPh = 2;
          drawRow(selectedItem % ITEMS_PER_PAGE);
        }
      } else {
        if (now - labelScrollMs >= 500) {
          labelScrollOff = 0;
          labelScrollPh  = 0;
          labelScrollMs  = now;
          drawRow(selectedItem % ITEMS_PER_PAGE);
        }
      }
    }
  }
}
