alexanderbarsuk/diesel-heater/(commit log)

2026-03-03 Initial commit: ATmega2560 diesel heater controller
    - ST7789 320x240 TFT display with 2-bit antialiased Ukrainian font (SF Mono 22pt)
    - Typed menu system: slider, checkbox, time, range, select, sub-menus
    - EEPROM persistence with per-item defaults
    - Encoder navigation with multi-field edit mode
2026-03-03 feat: typed menu, UA font AA, background image, explicit temp placement
    - screen_settings: typed menu items (SLIDER/CHECKBOX/TIME/RANGE/SELECT/SUBMENU/BACK),
    sub-menus (correction, danger), EEPROM layout with magic 0xA7
    - uaprint: 2-bit AA glyph renderer, printUAn for label scroll animation
    - screen_sensors: background bitmap via pgm_read_word_far, remove labels,
    explicit drawTemperature(x,y,t) calls with per-sensor coordinates
    - background.h: 234×94 RGB565 PROGMEM image split into 2 parts (<32KB each)
    - heater: full heater state machine (off/starting/running/stopping/fault)
    [MegaHeater2.ino, background.h, config.h, heater.cpp, heater.h, screen_sensors.cpp, screen_settings.cpp]
2026-03-10 feat: show background image at 1:1 pixel ratio (no scaling)
    - background.png (320×136) displayed at original size via crop, not resize
    - Switched from 3 parts × 40 rows to 4 parts × 34 rows (total 136px)
    - gen_bg.py: replaced LANCZOS resize with 1:1 pixel crop
    - screen_sensors.cpp: drawBackground() now draws all 4 bitmap parts
    - Replaced tools/background.bmp with tools/background.png (source image)
    - MegaHeater2.ino: removed leftover Serial debug prints
    [MegaHeater2.ino, background.h, screen_sensors.cpp]
2026-03-10 feat: add priming, fault sensors, valve/ignition/charger outputs, mode buttons
    - HEATER_PRIMING state: pump at max PWM while BUTTON held (hold mode)
    or for configurable duration (timer mode)
    - Contact sensors: SENSOR_EMERGENCY, SENSOR_FUEL_OVERFLOW, SENSOR_FUEL_MIN
    with edge-detection fault logging
    - FUEL_VALVE_PIN (8): open during STARTING/RUNNING/PRIMING, close on fault
    - IGNITION_PIN (9): active only during STARTING
    - CHARGER_PIN (27): HIGH when voltage < configurable threshold (default 10.5V)
    - Mode buttons with LEDs: BTN_HEAT/BTN_VENT (pins 28-31), changeable only when OFF
    - Settings: priming mode (hold/timer), priming duration, charger threshold
    - faults.cpp/h: fault log, EEPROM ri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
2026-03-10 feat: startup/restart/stop sequences, separate priming button, air-out thermocouple
    - HEATER_STARTING/RESTARTING: ignition on for configurable time, fan+pump
    at startup RPM; fire temp detection → RUNNING; timeout → RESTARTING →
    FAULT_NO_IGNITION + STOPPING
    - HEATER_STOPPING: cooling fan at configurable RPM, pump off; chamber
    temp ≤ coolStopTemp → OFF
    - PID targets switch per state: startup RPMs / power table / cooling RPM
    - PRIMING_BTN_PIN (32) separate from BUTTON (5, screen switching)
    - TC_AIR_OUT_CS (pin 12) replaces DS18B20 for air outlet temperature
    - Settings: new "Запуск" submenu (startup fan/pump RPM, fire temp,
    cooling fan RPM, stop temp); removed 5 unused ro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
    [config.h, heater.cpp, heater.h, screen_sensors.cpp, screen_settings.cpp]
2026-03-22 feat: ACS712 ignition current sensing, pump delay, improved icons, small font, README
    - ACS712F 20A on A1: measure ignition coil current, display near spark icon
    - FAULT_IGNITION_OPEN (code 12): triggers if current < min after 1s delay
    - Fault disabled when min current setting = 0
    - Startup pump delay setting (0–120s): pump stays off during ignition warm-up
    - Static detailed fan/pump icons (no animation), 3px smaller
    - FreeSans7pt7b (Arial 12px, cap 9px) for fan/pump and env blocks
    - Fan/pump/env blocks moved 4px down, 1px borders top and bottom
    - README: full wiring, state machine, fault list, all settings documented
2026-03-22 feat: buzzer on fault, active-HIGH sensors/buttons, README updates
    - Buzzer (pin 33): activates on any fault for configurable duration (0–30s, default 3s)
    - "Час бузера" setting added to Аварії submenu (valIdx 41, EEPROM addr 106)
    - Contact sensors (pins 24–26): INPUT_PULLUP → INPUT, logic inverted to HIGH = triggered
    - Mode buttons (28, 30) and priming button (32): same change to active-HIGH
    - README: state machine diagram shows ЗАПУСК → ПЕРЕЗАПУСК transition
    [config.h, heater.cpp, heater.h, screen_settings.cpp]
2026-03-22 feat: 2Hz clock, echo pin, AA font, blinking ignition icon, buzzer, README
    - Timer5 CTC: 2Hz hardware signal on pin 46 (OC5A), active from startup
    - Echo: pin 34 (input) mirrored to pin 35 (output) each loop()
    - FreeSans7pt7b: regenerated as 2-bit AA font (smallprint.h/cpp renderer)
    - Ignition icon: replaced spark plug with two concentric circles blinking at 2Hz
    - Buzzer (pin 33): sounds on fault for configurable duration (Аварії submenu)
    - Sensors/buttons: all switched to active-HIGH (INPUT, no pullup)
    - README: wiring tables, fault conditions, EEPROM map, settings updated
    [MegaHeater2.ino, clk2hz.cpp, clk2hz.h, config.h, screen_sensors.cpp, smallprint.cpp]
2026-03-22 feat: auto-cooling on startup if chamber overheated after power loss
    - On boot, read chamber temp after 300ms (MAX6675 warm-up)
    - If tempChamber > coolStopTemp → enter HEATER_STOPPING immediately
    - Fan runs at coolFanRpm until chamber cools, then transitions to OFF
    - README: added power-loss recovery section
    [heater.cpp]
